darshg321/Icey/assets/3DPCB.png

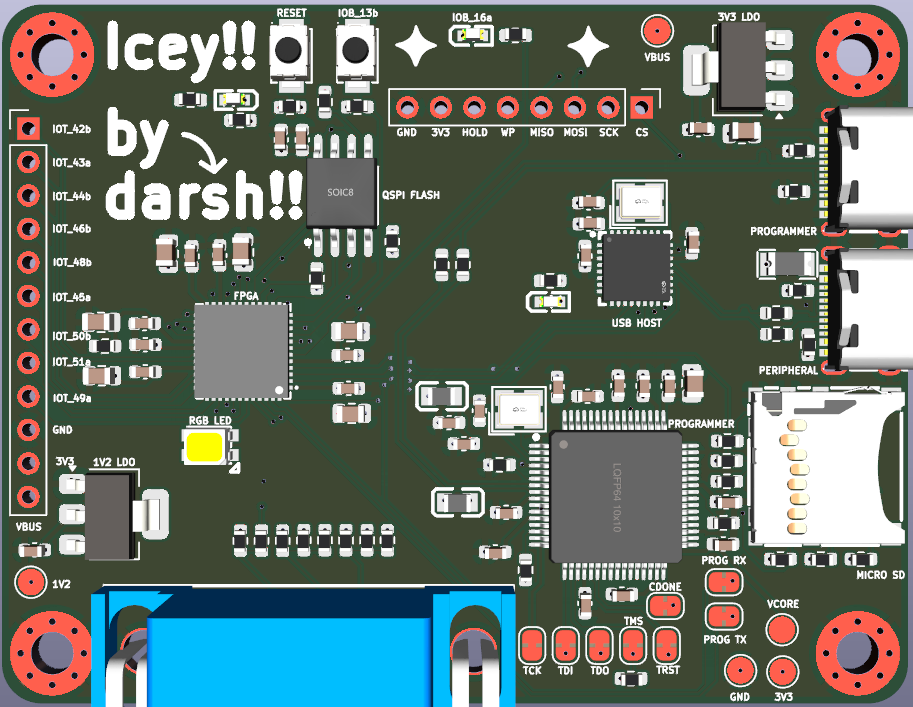
assets/3DPCB.png
