darshg321/Icey/assets/3DPCBBACK.png

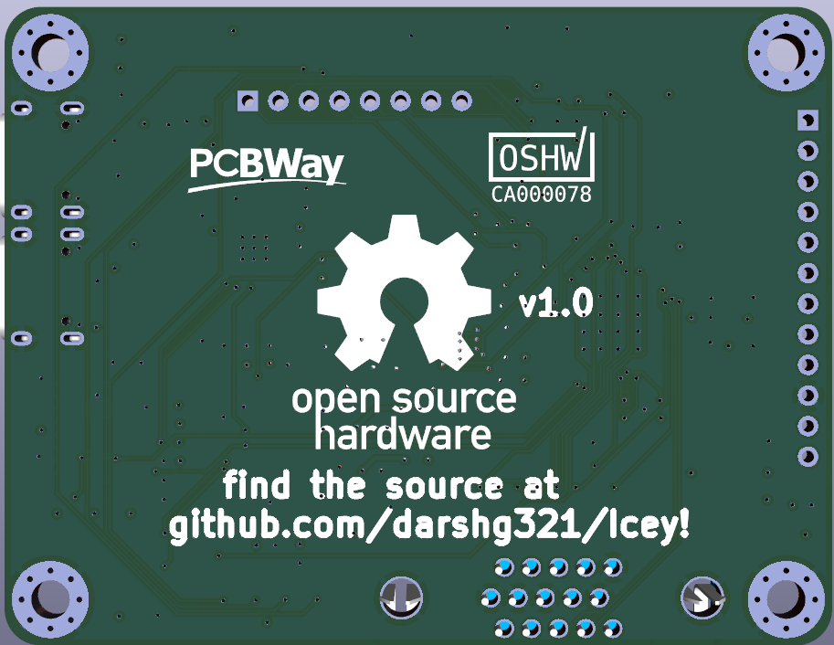
assets/3DPCBBACK.png
