darshg321/Icey/assets/3PCBBACK.png

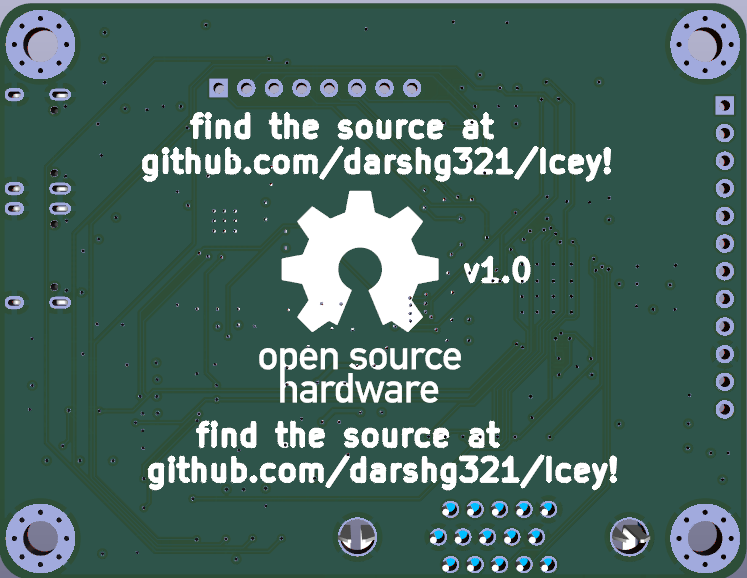
assets/3PCBBACK.png
