darshg321/Icey/assets/layer2.png

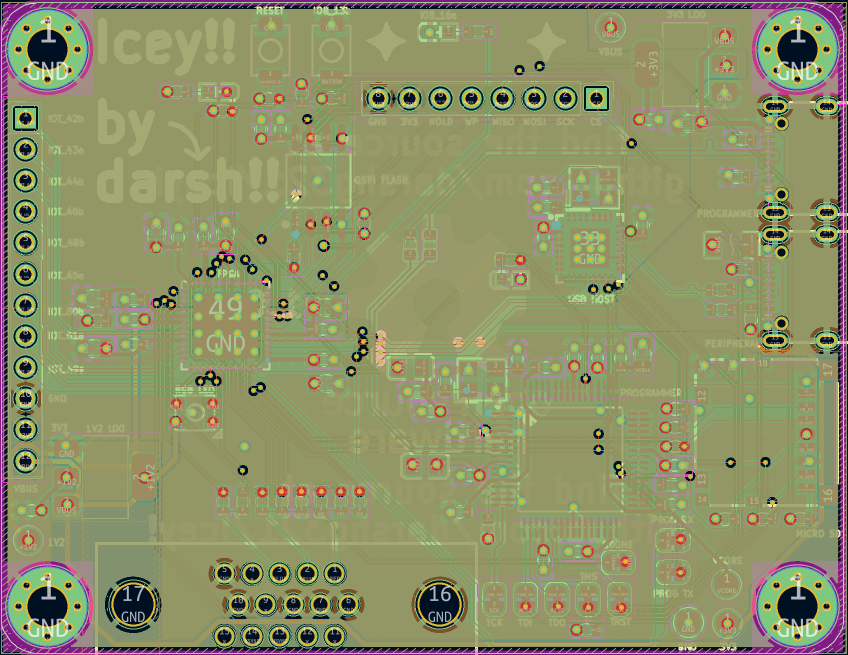
assets/layer2.png
