darshg321/Icey/assets/layer3.png

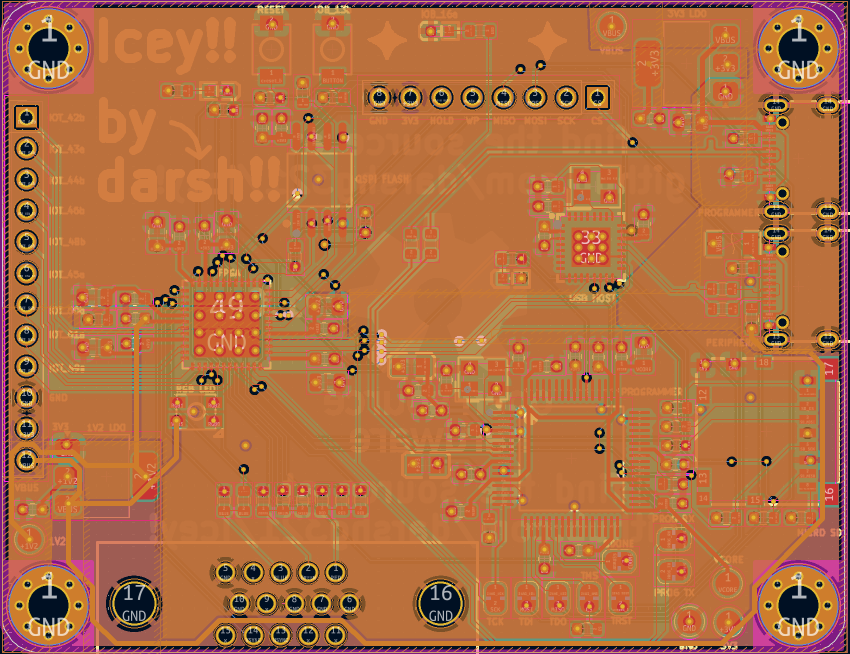
assets/layer3.png
