darshg321/Icey/assets/layer4.png

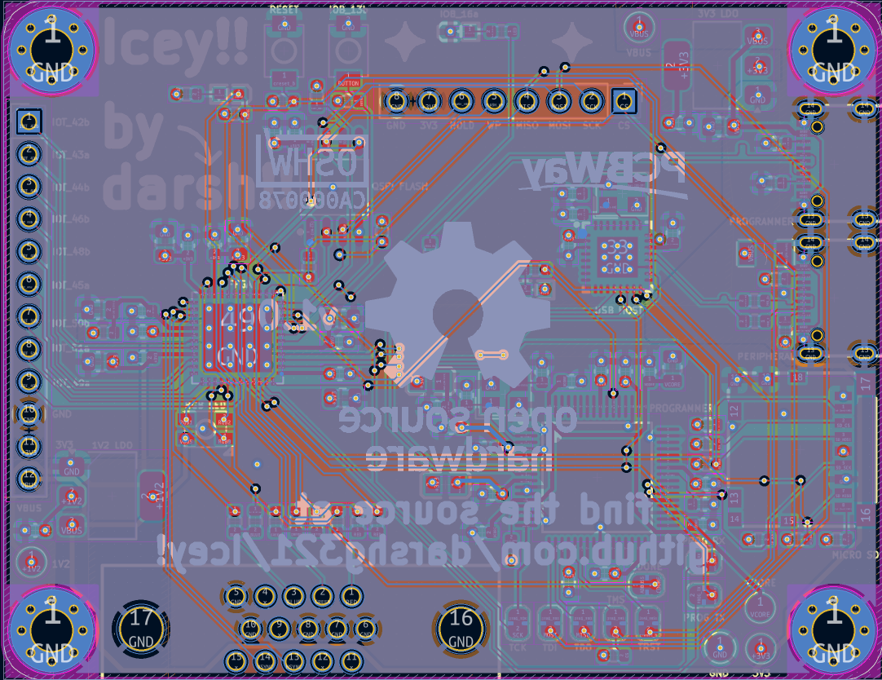
assets/layer4.png
