darshg321/Icey/JLC_BOM.csv

JLCPCB BOM Tool - BOM Matching
BOM name：production_bom-JLCPCB Assembly Order.xlsx |  |  | Download Time：2026-08-05 03:41:00 |  |  |  | * Our matching results are updated in real-time, but stock and prices may change. If it's been over 24 hours, please re-match before placing your order.
PCB Assembled Qty：5 |  |  | Est. Total Price：65.4232
Your BOM |  |  |  |  | Matched Parts |  |  |  |  |  |  | Order Information
Top Designator | Bottom Designator | Comment | Footprint | JLCPCB Part # | Matches | Part # | Manufacturer | Footprint | Description | Category | Warning | JLCPCB Part # | Product link | Lib Type | Qty | Source | Total Price ($)
C1,C14,C31,C33,C35,C37,C5,C9 |  | 4.7uF | 0805 |  | Select by System | CL21A475KAQNNNE | Samsung Electro-Mechanics | 0805 | 25V 4.7uF X5R ±10% 0805 Multilayer Ceramic Capacitors MLCC - SMD/SMT ROHS | Multilayer Ceramic Capacitors MLCC - SMD/SMT |  | C1779 | https://jlcpcb.com/partdetail/2131-CL21A475KAQNNNE/C1779 | Basic | 16 | 16 JLCPCB | 0.7264
C2,C26,C29,C4,C40 |  | 1uF | 0603 |  | Select by System | CL10A105KB8NNNC | Samsung Electro-Mechanics | 0603 | 1uF 50V X5R ±10% 0603 Multilayer Ceramic Capacitors MLCC - SMD/SMT ROHS | Multilayer Ceramic Capacitors MLCC - SMD/SMT |  | C15849 | https://jlcpcb.com/partdetail/16531-CL10A105KB8NNNC/C15849 | Basic | 10 | 10 JLCPCB | 0.756
C12,C13,C17,C18,C19,C20,C21,C22,C23,C24,C27,C3,C30,C32,C34,C36,C38,C39,C41,C8 |  | 100nF | 0603 |  | Select by System | CC0603KRX7R9BB104 | YAGEO | 0603 | 100nF 50V X7R ±10% 0603 Multilayer Ceramic Capacitors MLCC - SMD/SMT ROHS | Multilayer Ceramic Capacitors MLCC - SMD/SMT |  | C14663 | https://jlcpcb.com/partdetail/YAGEO-CC0603KRX7R9BB104/C14663 | Basic | 40 | 40 JLCPCB | 0.904
C15,C16,C6,C7 |  | 22pF | 0603 |  | Select by System | CL10C220JB8NNNC | Samsung Electro-Mechanics | 0603 | 22pF 50V C0G ±5% 0603 Multilayer Ceramic Capacitors MLCC - SMD/SMT ROHS | Multilayer Ceramic Capacitors MLCC - SMD/SMT |  | C1653 | https://jlcpcb.com/partdetail/2005-CL10C220JB8NNNC/C1653 | Basic | 8 | 8 JLCPCB | 0.0536
CARD1 |  | TF-008 | TF-SMD_TF-008 |  | Select by System | TF-008 | SOFNG | SMD | -35℃~+85℃ 1.35mm Connector and Ejector MicroSD Card (TF Card) Push-Pull Yes SMD SD Card / Memory Card Connector ROHS | SD Card / Memory Card Connector |  | C428465 | https://jlcpcb.com/partdetail/SOFNG-TF008/C428465 | Extended | 2 | 2 JLCPCB | 0.6584
DSUB1 |  | VGA-002 | D-SUB-TH_VGA-002 |  | Select by System | VGA-002 | BOOMELE(Boom Precision Elec) | 弯插 | 15P 3 30V 500mA Blue Female High Density D-Sub Right Angle 弯插 D-Sub / VGA Connectors ROHS | D-Sub / VGA Connectors |  | C138387 | https://jlcpcb.com/partdetail/BOOMELE_Boom_Precision_Elec-VGA002/C138387 | Extended | 2 | 2 JLCPCB | 0.5248
F1 |  | MF-NSMF020-2 | F1206 |  | Select by System | MF-NSMF020-2 | BOURNS | 1206 | -40℃~+85℃ 1.6mm 10A 2.6Ω 200mA 24V 3.2mm 600mΩ 1206 Resettable Fuses ROHS | Resettable Fuses |  | C185112 | https://jlcpcb.com/partdetail/BOURNS-MF_NSMF0202/C185112 | Extended | 6 | 6 JLCPCB | 0.2298
L1,L2 |  | 600@100MHz | L0805 |  | Select by System | GZ2012D601TF | Sunlord | 0805 | -55℃~+125℃ 1 300mΩ 500mA 600Ω@100MHz ±25% 0805 Ferrite Beads ROHS | Ferrite Beads |  | C1017 | https://jlcpcb.com/partdetail/Sunlord-GZ2012D601TF/C1017 | Basic | 4 | 4 JLCPCB | 0.1144
LED1,LED2,LED3 |  | KT-0603R | LED-SMD_L1.6-W0.8-R-RD |  | Select by System | KT-0603R | Hubei KENTO Elec | 0603 | -40℃~+85℃ 1.6mm x 0.8mm square LED 1.8V~2.4V 120° 20mA 300mcd 40mW 615nm~630nm 645nm Discrete Diode Red Water Clear 0603 LED Indication - Discrete ROHS | LED Indication - Discrete |  | C2286 | https://jlcpcb.com/partdetail/Hubei_KENTOElec-KT0603R/C2286 | Basic | 6 | 6 JLCPCB | 0.0444
LED4 |  | S4-3528RGBTA-A | LED-SMD_4P-L3.2-W2.8-LS3.5-TL-1 |  | Select by System | S4-3528RGBTA-A | TUOZHAN | SMD3528-4P | -40℃~+85℃ 1.9mm 120° 2.8mm 3.5mm B:461nm~470nm、G:518nm~527nm、R:617nm~626nm Common Anode G:2000V、B:2000V、R:2500V R:1.8V~2.4V、G:2.8V~3.4V、B:2.8V~3.4V R:20mA、G:20mA、B:20mA R:460mcd~1000mcd、G:1300mcd~2900mcd、B:350mcd~780mcd R:60mW、G:90mW、B:90mW Water Clear SMD3528-4P RGB LEDs ROHS | RGB LEDs |  | C2827321 | https://jlcpcb.com/partdetail/TUOZHAN-S4_3528RGBTAA/C2827321 | Extended | 10 | 10 JLCPCB | 0.262
R3,R4 |  | 5.1K | 0603 |  | Unconfirmed | 0603WAF5101T5E | UNI-ROYAL(Uniroyal Elec) | 0603 | -55℃~+155℃ 100mW 5.1kΩ 75V Thick Film Resistor ±1% ±100ppm/℃ 0603 Chip Resistor - Surface Mount ROHS | Chip Resistor - Surface Mount | 1.The comment (0603WAF5101T5E) of this part does not match the one (5.1K) provided in your BOM. Please confirm; | C23186 | https://jlcpcb.com/partdetail/23913-0603WAF5101T5E/C23186 | Basic | 4 | 4 JLCPCB | 0.0336
R5,R6 |  | 33 | 0603 |  | Unconfirmed | 0603WAF330JT5E | UNI-ROYAL(Uniroyal Elec) | 0603 | -55℃~+155℃ 100mW 33Ω 75V Thick Film Resistor ±1% ±100ppm/℃ 0603 Chip Resistor - Surface Mount ROHS | Chip Resistor - Surface Mount | 1.The comment (0603WAF330JT5E) of this part does not match the one (33) provided in your BOM. Please confirm; | C23140 | https://jlcpcb.com/partdetail/23867-0603WAF330JT5E/C23140 | Basic | 4 | 4 JLCPCB | 0.0316
R14,R15,R35 |  | 0 | 0603 |  | Unconfirmed | 0603WAF0000T5E | UNI-ROYAL(Uniroyal Elec) | 0603 | -55℃~+155℃ 0Ω 100mW 75V Thick Film Resistor ±1% 0603 Chip Resistor - Surface Mount ROHS | Chip Resistor - Surface Mount | 1.The comment (0603WAF0000T5E) of this part does not match the one (0) provided in your BOM. Please confirm; | C21189 | https://jlcpcb.com/partdetail/21903-0603WAF0000T5E/C21189 | Basic | 6 | 6 JLCPCB | 0.0492
R16 |  | 12K | 0603 |  | Unconfirmed | 0603WAF1202T5E | UNI-ROYAL(Uniroyal Elec) | 0603 | -55℃~+155℃ 100mW 12kΩ 75V Thick Film Resistor ±1% ±100ppm/℃ 0603 Chip Resistor - Surface Mount ROHS | Chip Resistor - Surface Mount | 1.The comment (0603WAF1202T5E) of this part does not match the one (12K) provided in your BOM. Please confirm; | C22790 | https://jlcpcb.com/partdetail/23517-0603WAF1202T5E/C22790 | Basic | 2 | 2 JLCPCB | 0.0172
R17,R19,R20,R21,R34,R38,R39,R41,R42,R45,R46,R47,R48 |  | 10K | 0603 |  | Unconfirmed | 0603WAF1002T5E | UNI-ROYAL(Uniroyal Elec) | 0603 | -55℃~+155℃ 100mW 10kΩ 75V Thick Film Resistor ±1% ±100ppm/℃ 0603 Chip Resistor - Surface Mount ROHS | Chip Resistor - Surface Mount | 1.The comment (0603WAF1002T5E) of this part does not match the one (10K) provided in your BOM. Please confirm; | C25804 | https://jlcpcb.com/partdetail/26547-0603WAF1002T5E/C25804 | Basic | 26 | 26 JLCPCB | 0.0546
R18 |  | 270 | 0603 |  | Unconfirmed | 0603WAF2700T5E | UNI-ROYAL(Uniroyal Elec) | 0603 | -55℃~+155℃ 100mW 270Ω 75V Thick Film Resistor ±1% ±100ppm/℃ 0603 Chip Resistor - Surface Mount ROHS | Chip Resistor - Surface Mount | 1.The comment (0603WAF2700T5E) of this part does not match the one (270) provided in your BOM. Please confirm; | C22966 | https://jlcpcb.com/partdetail/23693-0603WAF2700T5E/C22966 | Basic | 2 | 2 JLCPCB | 0.0054
R24,R28,R32,R36 |  | 510 | 0603 |  | Unconfirmed | 0603WAF5100T5E | UNI-ROYAL(Uniroyal Elec) | 0603 | -55℃~+155℃ 100mW 510Ω 75V Thick Film Resistor ±1% ±100ppm/℃ 0603 Chip Resistor - Surface Mount ROHS | Chip Resistor - Surface Mount | 1.The comment (0603WAF5100T5E) of this part does not match the one (510) provided in your BOM. Please confirm; | C23193 | https://jlcpcb.com/partdetail/23920-0603WAF5100T5E/C23193 | Basic | 8 | 8 JLCPCB | 0.0816
R25,R29,R9 |  | 1K | 0603 |  | Unconfirmed | 0603WAF1001T5E | UNI-ROYAL(Uniroyal Elec) | 0603 | -55℃~+155℃ 100mW 1kΩ 75V Thick Film Resistor ±1% ±100ppm/℃ 0603 Chip Resistor - Surface Mount ROHS | Chip Resistor - Surface Mount | 1.The comment (0603WAF1001T5E) of this part does not match the one (1K) provided in your BOM. Please confirm; | C21190 | https://jlcpcb.com/partdetail/21904-0603WAF1001T5E/C21190 | Basic | 6 | 6 JLCPCB | 0.036
R26,R27 |  | 2K | 0603 |  | Unconfirmed | 0603WAF2001T5E | UNI-ROYAL(Uniroyal Elec) | 0603 | -55℃~+155℃ 100mW 2kΩ 75V Thick Film Resistor ±1% ±100ppm/℃ 0603 Chip Resistor - Surface Mount ROHS | Chip Resistor - Surface Mount | 1.The comment (0603WAF2001T5E) of this part does not match the one (2K) provided in your BOM. Please confirm; | C22975 | https://jlcpcb.com/partdetail/23702-0603WAF2001T5E/C22975 | Basic | 4 | 4 JLCPCB | 0.036
R30 |  | 820 | 0603 |  | Unconfirmed | 0603WAF8200T5E | UNI-ROYAL(Uniroyal Elec) | 0603 | -55℃~+155℃ 100mW 75V 820Ω Thick Film Resistor ±1% ±100ppm/℃ 0603 Chip Resistor - Surface Mount ROHS | Chip Resistor - Surface Mount | 1.The comment (0603WAF8200T5E) of this part does not match the one (820) provided in your BOM. Please confirm; | C23253 | https://jlcpcb.com/partdetail/23980-0603WAF8200T5E/C23253 | Basic | 2 | 2 JLCPCB | 0.005
R31 |  | 430 | 0603 |  | Select by Customer | 0603WAF4302T5E | UNI-ROYAL(Uniroyal Elec) | 0603 | -55℃~+155℃ 100mW 43kΩ 75V Thick Film Resistor ±1% ±100ppm/℃ 0603 Chip Resistor - Surface Mount ROHS | Chip Resistor - Surface Mount | 1.The comment (0603WAF4302T5E) of this part does not match the one (430) provided in your BOM. Please confirm; | C23172 | https://jlcpcb.com/partdetail/23899-0603WAF4302T5E/C23172 | Extended | 20 | 20 JLCPCB | 0.152
R33 |  | 100 | 0603 |  | Unconfirmed | 0603WAF1000T5E | UNI-ROYAL(Uniroyal Elec) | 0603 | -55℃~+155℃ 100mW 100Ω 75V Thick Film Resistor ±1% ±100ppm/℃ 0603 Chip Resistor - Surface Mount ROHS | Chip Resistor - Surface Mount | 1.The comment (0603WAF1000T5E) of this part does not match the one (100) provided in your BOM. Please confirm; | C22775 | https://jlcpcb.com/partdetail/23502-0603WAF1000T5E/C22775 | Basic | 2 | 2 JLCPCB | 0.0064
R40,R44 |  | 56K | 0603 |  | Unconfirmed | 0603WAF5602T5E | UNI-ROYAL(Uniroyal Elec) | 0603 | -55℃~+155℃ 100mW 56kΩ 75V Thick Film Resistor ±1% ±100ppm/℃ 0603 Chip Resistor - Surface Mount ROHS | Chip Resistor - Surface Mount | 1.The comment (0603WAF5602T5E) of this part does not match the one (56K) provided in your BOM. Please confirm; | C23206 | https://jlcpcb.com/partdetail/23933-0603WAF5602T5E/C23206 | Basic | 4 | 4 JLCPCB | 0.0324
SW2,SW3 |  | TS-1088-AR02016 | SW-SMD_L3.9-W3.0-P4.45 |  | Select by System | TS-1088-AR02016 | XUNPU | SMD,4x3mm | -30℃~+80℃ 1.6N 100,000 cycles 12V 2mm 3.9mm 3mm 50mA Black Round Button SMD(SMT) Tab SPST Surface Mount,Vertical Without Bracket SMD,4x3mm Tactile Switches ROHS | Tactile Switches |  | C720477 | https://jlcpcb.com/partdetail/XUNPU-TS_1088AR02016/C720477 | Basic | 4 | 4 JLCPCB | 0.2208
U1 |  | AMS1117-1.2 | SOT-223-3_TabPin2 |  | Select by System | AMS1117-1.2 | UMW(Youtai Semiconductor Co., Ltd.) | SOT-223 | -40℃~+125℃@(Tj) 0.003%Vout 1 1.2V 1.3V@(1A) 10mA 18V 1A 60dB@(120Hz) Fixed Over Current Protection Positive SOT-223 Voltage Regulators - Linear, Low Drop Out (LDO) Regulators ROHS | Voltage Regulators - Linear, Low Drop Out (LDO) Regulators |  | C347218 | https://jlcpcb.com/partdetail/323878-AMS1117_12/C347218 | Extended | 2 | 2 JLCPCB | 0.1002
U2 |  | ICE40UP5K-SG48I | QFN-48_L7.0-W7.0-P0.50-TL-EP5.4-1 |  | Select by System | ICE40UP5K-SG48I | Lattice | QFN-48-EP(7x7) | -40℃~+100℃ 1171456bit 5280 660 QFN-48-EP(7x7) Programmable Logic Device (CPLDs/FPGAs) ROHS | Programmable Logic Device (CPLDs/FPGAs) |  | C2678152 | https://jlcpcb.com/partdetail/Lattice-ICE40UP5KSG48I/C2678152 | Extended | 2 | 2 JLCPCB | 16.9878
U3 |  | MAX3421EETJ+T | VQFN-32_L5.0-W5.0-P0.50-BL-EP3.2 |  | Select by System | MAX3421EETJ+T | Analog Devices Inc./Maxim Integrated | VQFN-32-EP(5x5) | -40℃~+85℃ 12Mbps 3.3V 45mA 60uA USB 2.0 USB to SPI VQFN-32-EP(5x5) USB Converters ROHS | USB Converters |  | C1870151 | https://jlcpcb.com/partdetail/1960966-MAX3421EETJT/C1870151 | Extended | 2 | 2 JLCPCB | 13.183
U4 |  | W25Q128JVSIQTR | SOIC-8_L5.3-W5.3-P1.27-LS8.0-BL |  | Select by System | W25Q128JVSIQ | Winbond Elec | SOIC-8-208mil | -40℃~+85℃ 100,000 cycles 120ms@(32KB) 128Mbit 133MHz 1uA 2.7V~3.6V 20 Years 3ms Power-on reset、Hardware write protection、Software write protection、Write enable latch、Absolute write protection SPI SOIC-8-208mil NOR FLASH ROHS | NOR FLASH |  | C97521 | https://jlcpcb.com/partdetail/WinbondElec-W25Q128JVSIQ/C97521 | Basic | 2 | 2 JLCPCB | 5.5218
U5 |  | AMS1117-3.3 | SOT-223-3_TabPin2 |  | Select by System | AMS1117-3.3 | Advanced Monolithic Systems | SOT-223 | -40℃~+125℃ 0.003%Vout 1 1.1V@(800mA) 15V 1A 3.3V 5mA 72dB@(120Hz) Fixed Over Current Protection、Short Circuit Protection、Thermal shutdown Positive SOT-223 Voltage Regulators - Linear, Low Drop Out (LDO) Regulators ROHS | Voltage Regulators - Linear, Low Drop Out (LDO) Regulators |  | C6186 | https://jlcpcb.com/partdetail/Advanced_MonolithicSystems-AMS1117_33/C6186 | Basic | 2 | 2 JLCPCB | 0.4012
U6 |  | FT2232HL | LQFP-64_L10.0-W10.0-P0.50-LS12.0-TL |  | Select by System | FT2232HL-REEL | FTDI | LQFP-64(10x10) | -40℃~+85℃ 2 480Mbps USB 2.0 USB to UART、USB to FIFO LQFP-64(10x10) USB Converters ROHS | USB Converters |  | C27882 | https://jlcpcb.com/partdetail/FTDI-FT2232HLREEL/C27882 | Extended | 2 | 2 JLCPCB | 23.4452
USB1,USB2 |  | TYPE-C16PIN2MD | USB-C-SMD_TYPE-C-16PIN-2MD-073 |  | Select by System | TYPE-C 16PIN 2MD(073) | SHOU HAN | SMD | -25℃~+85℃ 1 16P 3A 5,000 times 5V Black Female Surface Mount, Right Angle Type-C SMD USB Connectors ROHS | USB Connectors |  | C2765186 | https://jlcpcb.com/partdetail/SHOUHAN-TYPE_C_16PIN_2MD_073/C2765186 | Extended | 5 | 5 JLCPCB | 0.368
X1,X2 |  | X322512MSB4SI | CRYSTAL-SMD_4P-L3.2-W2.5-BL |  | Select by System | X322512MSB4SI | YXC Crystal Oscillators | SMD3225-4P | -40℃~+85℃ 12MHz 20pF Crystal Oscillator ±10ppm ±20ppm SMD3225-4P Crystals ROHS | Crystals |  | C9002 | https://jlcpcb.com/partdetail/YXC_CrystalOscillators-X322512MSB4SI/C9002 | Basic | 4 | 4 JLCPCB | 0.3804
