darshg321/Icey/production/production_bom.csv

Designator | Footprint | Quantity | Value | LCSC Part #
C1, C14, C31, C33, C35, C37, C5, C9 | 0805 | 8 | 4.7uF
C12, C13, C17, C18, C19, C20, C21, C22, C23, C24, C27, C3, C30, C32, C34, C36, C38, C39, C41, C8 | 0603 | 20 | 100nF
C15, C16, C6, C7 | 0603 | 4 | 22pF
C2, C26, C29, C4, C40 | 0603 | 5 | 1uF
CARD1 | TF-SMD_TF-008 | 1 | TF-008 | C428465
DSUB1 | D-SUB-TH_VGA-002 | 1 | VGA-002 | C138387
F1 | F1206 | 1 | MF-NSMF020-2 | C185112
J1 | PinHeader_1x12_P2.54mm_Vertical | 1 | Conn_01x12
J2 | PinHeader_1x08_P2.54mm_Vertical | 1 | Conn_01x08
L1, L2 | L0805 | 2 | 600@100MHz | C1017
LED1, LED2, LED3 | LED-SMD_L1.6-W0.8-R-RD | 3 | KT-0603R | C2286
LED4 | LED-SMD_4P-L3.2-W2.8-LS3.5-TL-1 | 1 | S4-3528RGBTA-A | C2827321
R14, R15, R35 | 0603 | 3 | 0
R16 | 0603 | 1 | 12K
R17, R19, R20, R21, R34, R38, R39, R41, R42, R45, R46, R47, R48 | 0603 | 13 | 10K
R18 | 0603 | 1 | 270
R24, R28, R32, R36 | 0603 | 4 | 510
R25, R29, R9 | 0603 | 3 | 1K
R26, R27 | 0603 | 2 | 2K
R3, R4 | 0603 | 2 | 5.1K
R30 | 0603 | 1 | 820
R31 | 0603 | 1 | 430
R33 | 0603 | 1 | 100
R40, R44 | 0603 | 2 | 56K
R5, R6 | 0603 | 2 | 33
SW2, SW3 | SW-SMD_L3.9-W3.0-P4.45 | 2 | TS-1088-AR02016 | C720477
TP3, TP4, TP5, TP6, TP7 | TestPoint_Pad_D2.0mm | 5 | TestPoint
U1 | SOT-223-3_TabPin2 | 1 | AMS1117-1.2 | C347218
U2 | QFN-48_L7.0-W7.0-P0.50-TL-EP5.4-1 | 1 | ICE40UP5K-SG48I | C2678152
U3 | VQFN-32_L5.0-W5.0-P0.50-BL-EP3.2 | 1 | MAX3421EETJ+T | C1870151
U4 | SOIC-8_L5.3-W5.3-P1.27-LS8.0-BL | 1 | W25Q128JVSIQTR | C97521
U5 | SOT-223-3_TabPin2 | 1 | AMS1117-3.3
U6 | LQFP-64_L10.0-W10.0-P0.50-LS12.0-TL | 1 | FT2232HL | C27882
USB1, USB2 | USB-C-SMD_TYPE-C-16PIN-2MD-073 | 2 | TYPE-C 16PIN 2MD | C2765186
X1, X2 | CRYSTAL-SMD_4P-L3.2-W2.5-BL | 2 | X322512MSB4SI | C9002
