darshg321/Icey/JOURNAL.md

https://lapse.hackclub.com/timelapse/dUVuQwtGuoNT

https://lapse.hackclub.com/timelapse/kNoydn3p9_2V

https://lapse.hackclub.com/timelapse/Cn0KKLVaR2lX

https://lapse.hackclub.com/timelapse/0yt4nqLieavU

https://lapse.hackclub.com/timelapse/_wR7-a1GJmWD

https://lapse.hackclub.com/timelapse/y3aPzREroL90

https://lapse.hackclub.com/timelapse/l5Toxhs7gonE

https://lapse.hackclub.com/timelapse/NctV_41U334b

https://lapse.hackclub.com/timelapse/pN3W1glCVihE

https://lapse.hackclub.com/timelapse/RcOzTzJwzCnX

https://lapse.hackclub.com/timelapse/EgeR_TH6Yb6Q

https://lapse.hackclub.com/timelapse/sCd1icvFmEO3

https://lapse.hackclub.com/timelapse/YxfY_EIsNyJi

https://lapse.hackclub.com/timelapse/UKDQ6DKfIyNX

https://lapse.hackclub.com/timelapse/0LZ5_5kxrGnq

https://lapse.hackclub.com/timelapse/M3O1-R4e4S4K

https://lapse.hackclub.com/timelapse/71hZzpOUVf9u

https://lapse.hackclub.com/timelapse/fiwIgdSgkEqM
