darshg321/Icey/assets/SCHEMATIC.pdf

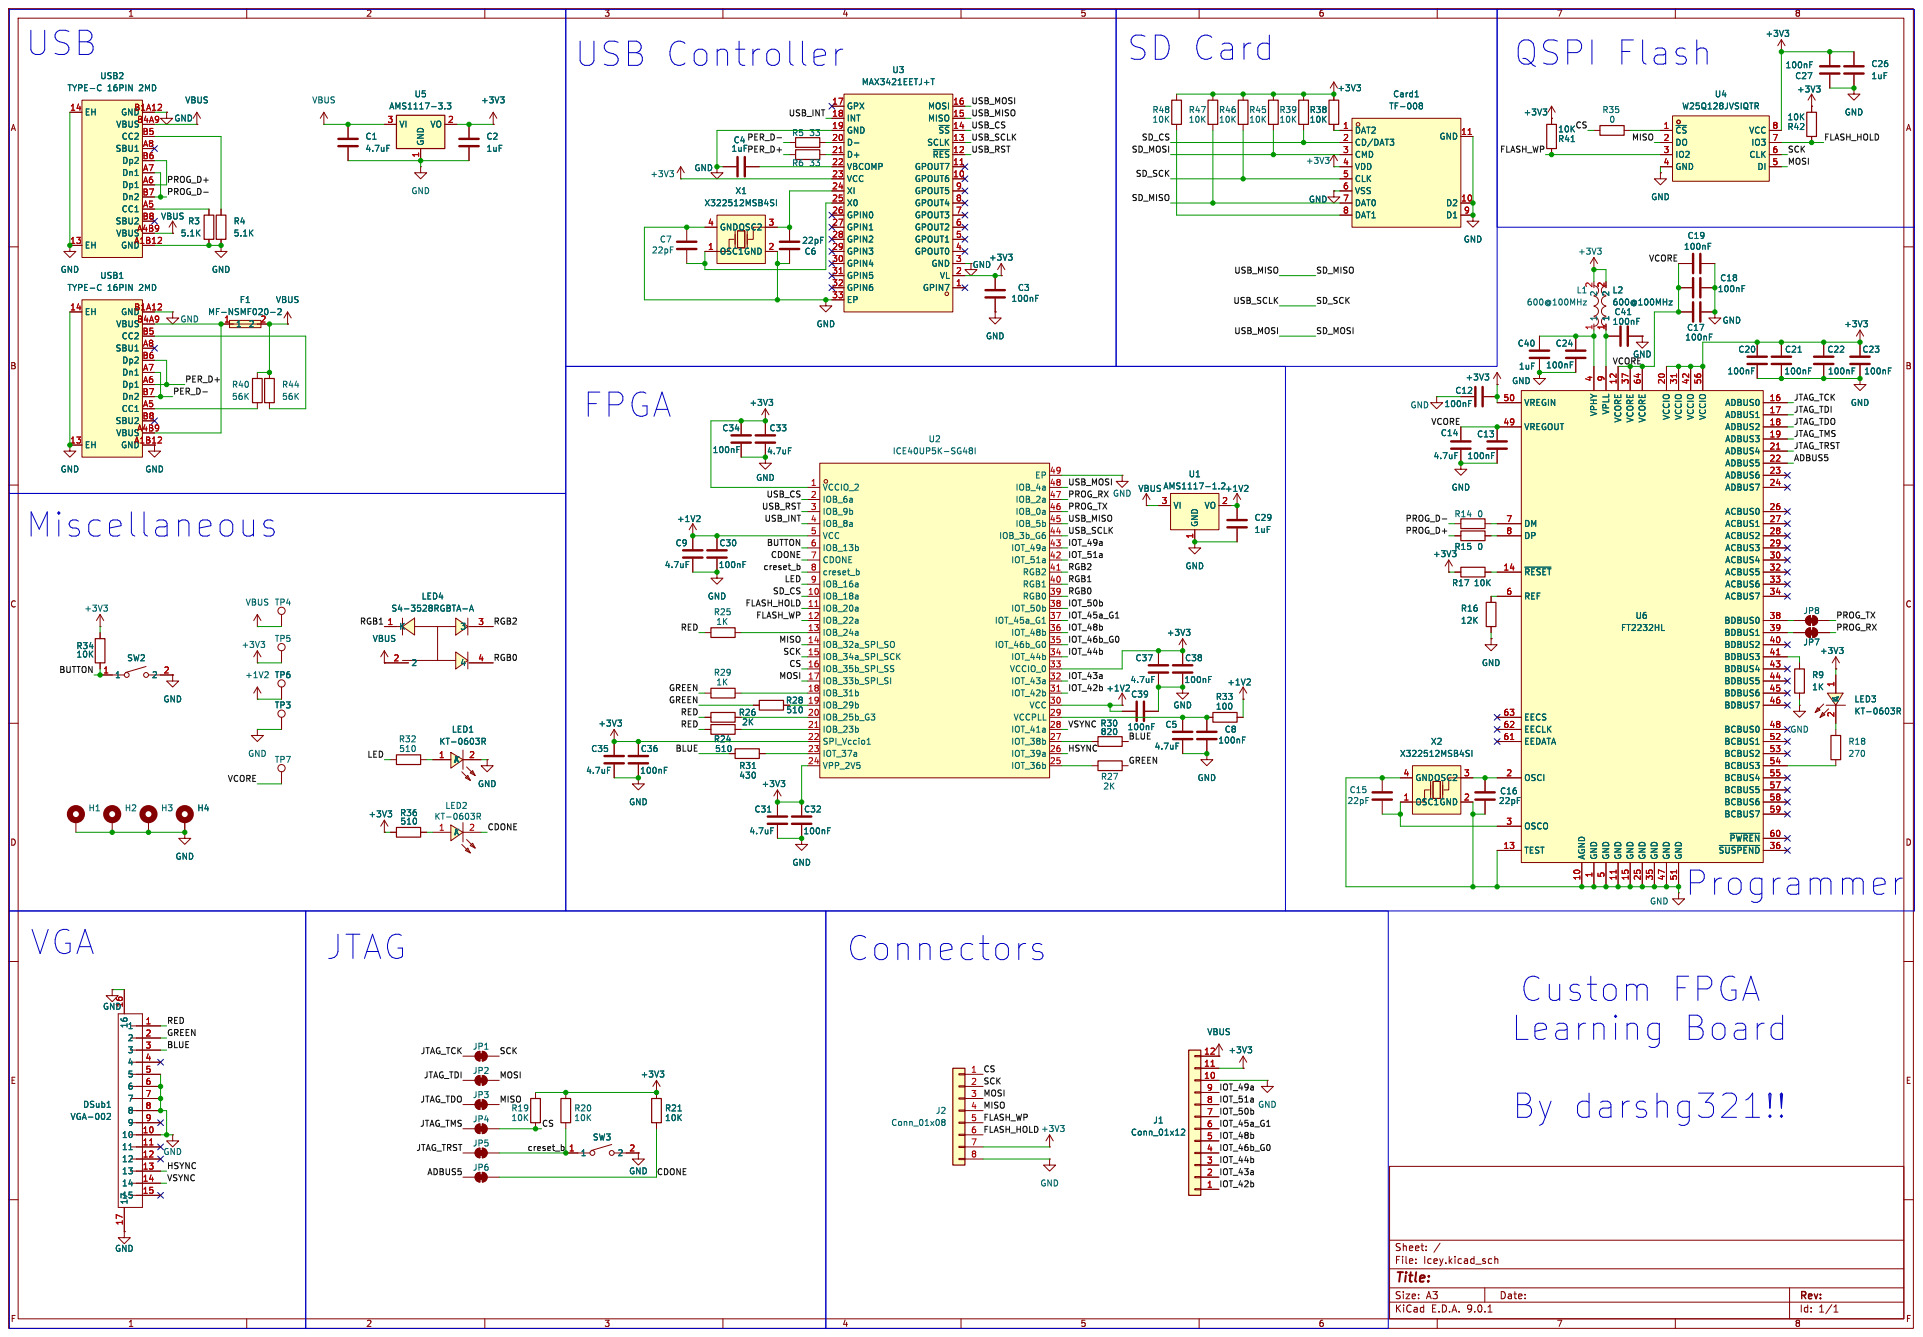
[picture p17: page 1]

USB
USB2 TYPE-C 16PIN 2MD GNDA1B12 VBUSA4B9 SBU2 B8 CC1 A5 Dn2 B7 Dp1 A6 Dn1 A7 Dp2 B6 SBU1 A8 CC2 B5 VBUSB4A9 GNDB1A12 EH 13 EH 14 GND

U3 MAX3421EETJ+TGPIN7 1 VL 2 GND 3 GPOUT0 4 GPOUT1 5 GPOUT2 6 GPOUT3 7 GPOUT4 8 GPOUT5 9 GPOUT6 10 GPOUT7 11 ~{RES} 12 SCLK 13 ~{SS} 14 MISO 15 MOSI 16 EP 33 GPIN6 32 GPIN5 31 GPIN4 30 GPIN3 29 GPIN2 28 GPIN1 27 GPIN0 26 X0 25 XI 24 VCC 23 VBCOMP 22 D+ 21 D- 20 GND 19

5 VCORE 12 GND 11 VCORE 37 GND 15 VCORE 64 GND 25 GND 35 VCCIO 20 GND 47 VCCIO 31 GND 51 VCCIO 42 VCCIO 56 ADBUS0

1 +3V3 U6 FT2232HL VREGIN 50 VREGOUT 49 DM 7 DP 8 ~{RESET} 14 REF 6 EECS 63 EECLK 62 EEDATA 61 OSCI 2 OSCO 3 TEST 13 AGND 10 VPHY
