darshg321/Icey/PCB/Icey.kicad_pcb

## KiCad design PCB/Icey.kicad_pcb (2026-08-17)

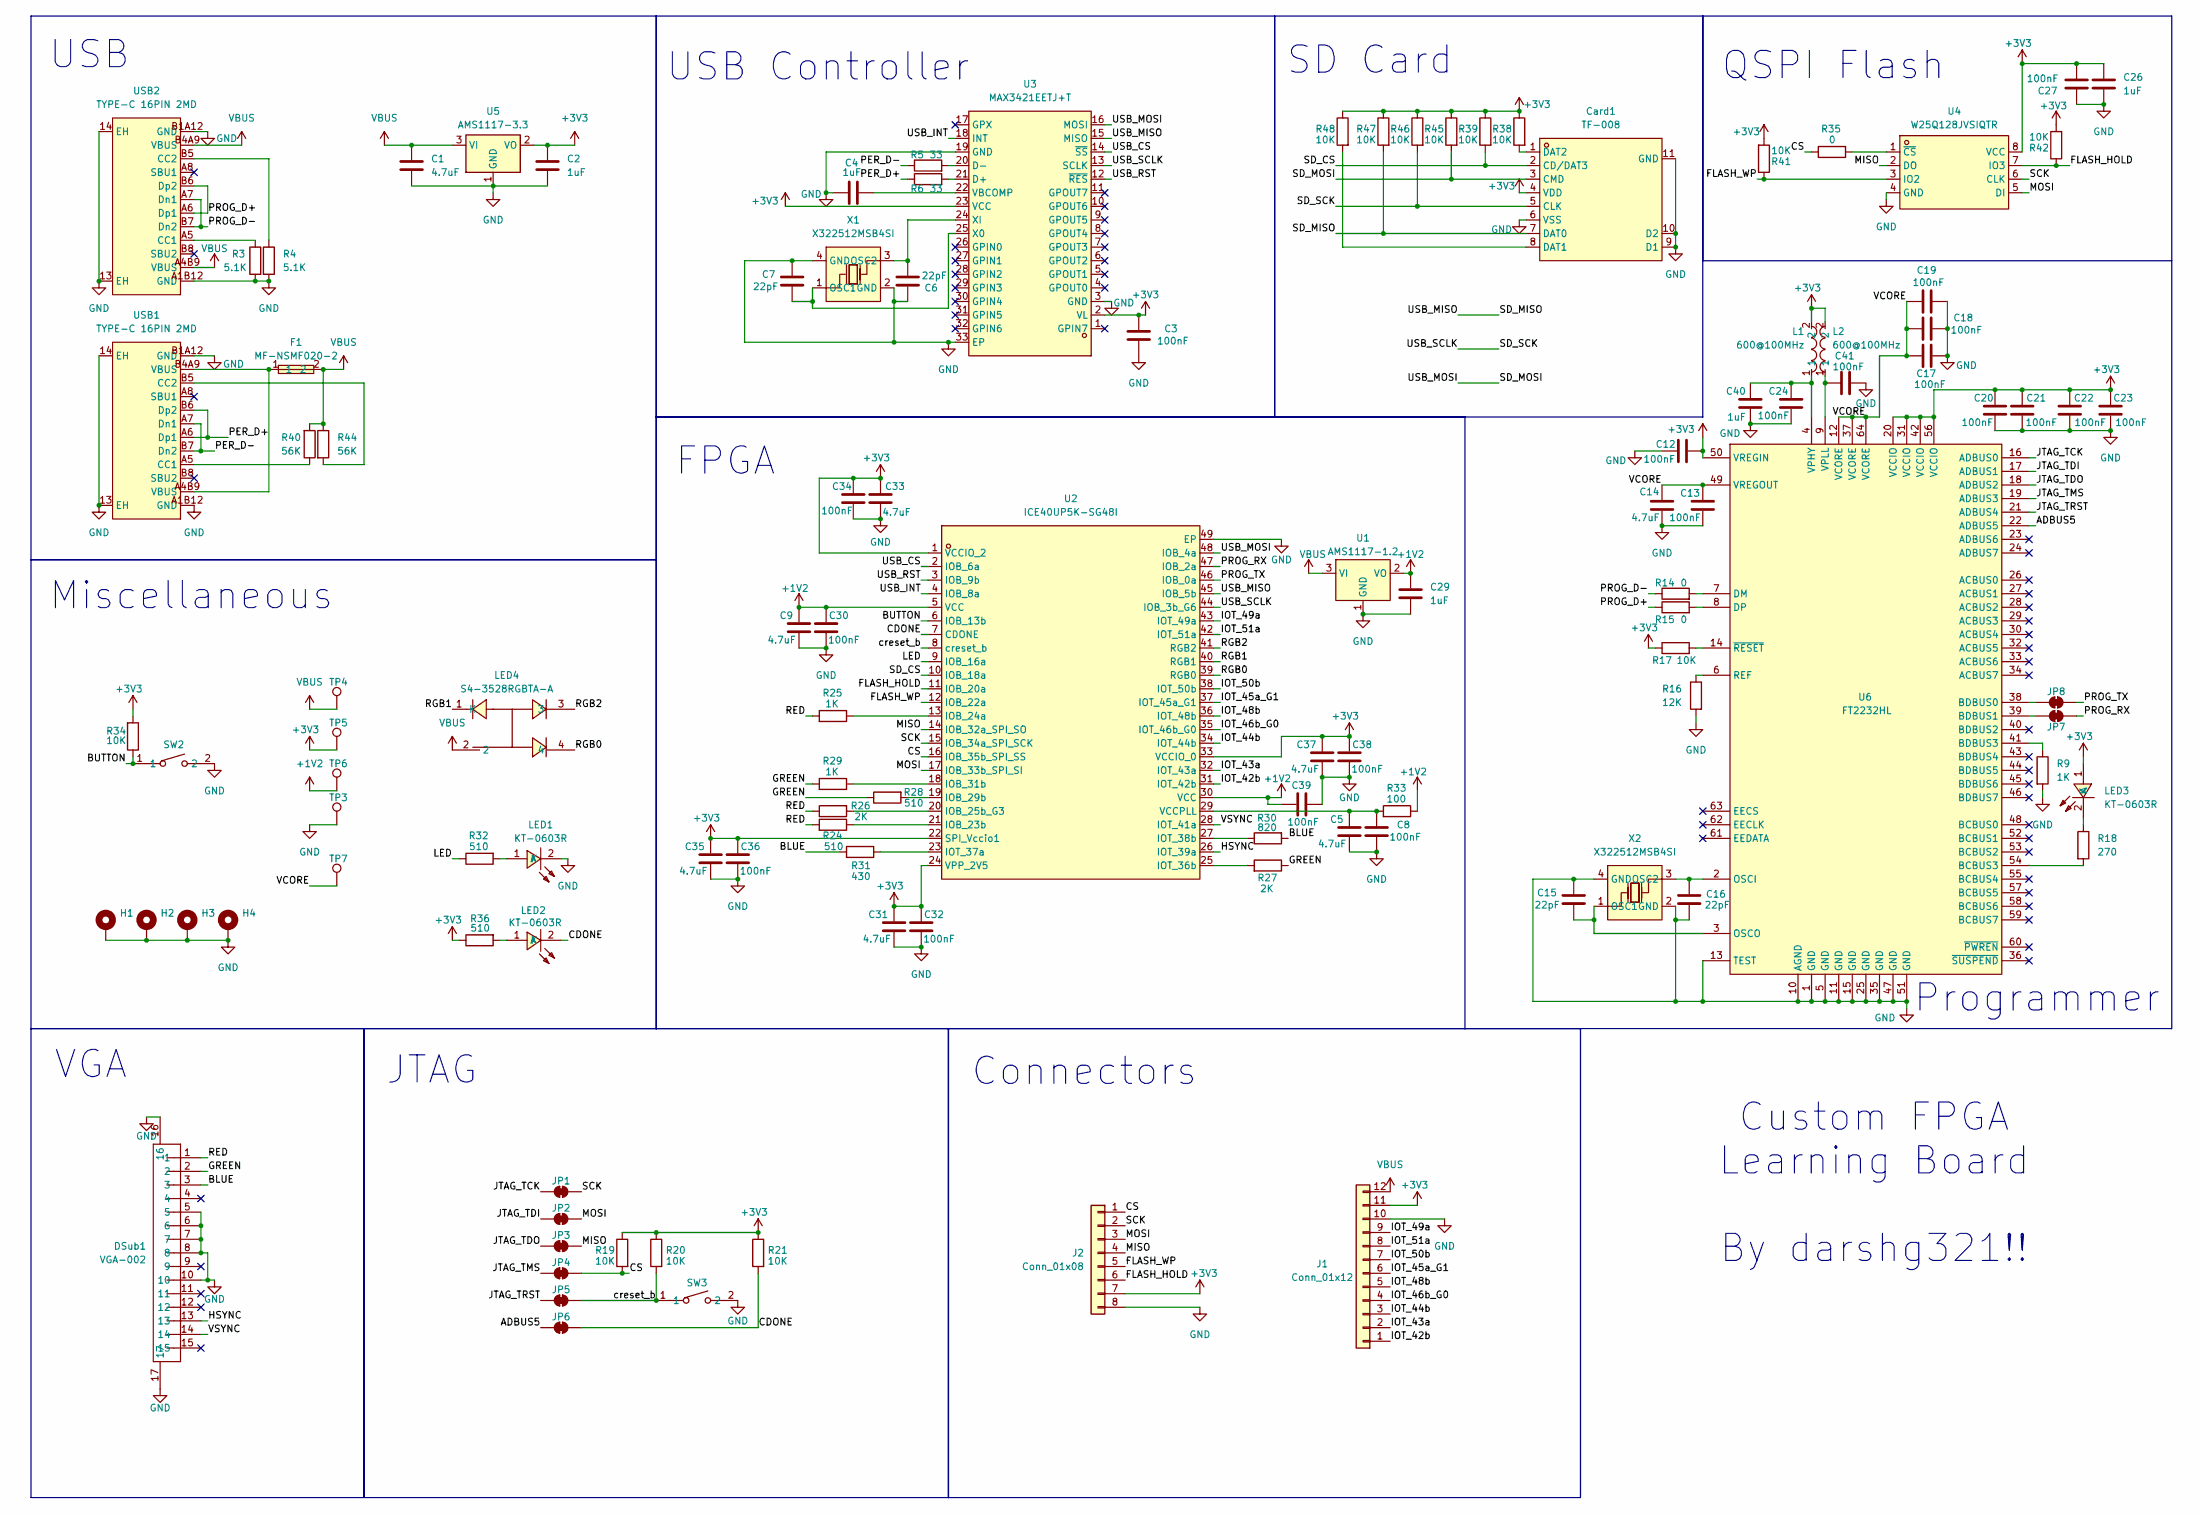
[picture p18: schematic Icey.kicad_sch]

Parts:
C1, C5, C9, C14, C31, C33, C35, C37: 4.7uF; C_0805_2012Metric
C2, C4, C26, C29, C40: 1uF; C_0603_1608Metric
C3, C8, C12, C13, C17, C18, C19, C20, C21, C22, C23, C24, C27, C30, C32, C34, C36, C38, C39, C41: 100nF; C_0603_1608Metric
C6, C7, C15, C16: 22pF; C_0603_1608Metric
Card1: TF-008; TF-SMD_TF-008; MPN TF-008; LCSC Part C428465
DSub1: VGA-002; D-SUB-TH_VGA-002; MPN VGA-002; LCSC Part C138387
F1: MF-NSMF020-2; F1206; MPN MF-NSMF020-2; LCSC Part C185112
H1, H2, H3, H4: MountingHole_Pad; MountingHole_3.2mm_M3_Pad_Via
J1: Conn_01x12; PinHeader_1x12_P2.54mm_Vertical
J2: Conn_01x08; PinHeader_1x08_P2.54mm_Vertical
JP1, JP2, JP3, JP4, JP5, JP6, JP7, JP8: SolderJumper_2_Bridged; SolderJumper-2_P1.3mm_Bridged_RoundedPad1.0x1.5mm
L1, L2: 600@100MHz; L0805; MPN GZ2012D601TF; LCSC Part C1017
LED1, LED2, LED3: KT-0603R; LED-SMD_L1.6-W0.8-R-RD; MPN KT-0603R; LCSC Part C2286
LED4: S4-3528RGBTA-A; LED-SMD_4P-L3.2-W2.8-LS3.5-TL-1; MPN S4-3528RGBTA-A; LCSC Part C2827321
R3, R4: 5.1K; R_0603_1608Metric
R5, R6: 33; R_0603_1608Metric
R9, R25, R29: 1K; R_0603_1608Metric
R14, R15, R35: 0; R_0603_1608Metric
R16: 12K; R_0603_1608Metric
R17, R19, R20, R21, R34, R38, R39, R41, R42, R45, R46, R47, R48: 10K; R_0603_1608Metric
R18: 270; R_0603_1608Metric
R24, R28, R32, R36: 510; R_0603_1608Metric
R26, R27: 2K; R_0603_1608Metric
R30: 820; R_0603_1608Metric
R31: 430; R_0603_1608Metric
R33: 100; R_0603_1608Metric
R40, R44: 56K; R_0603_1608Metric
SW2, SW3: TS-1088-AR02016; SW-SMD_L3.9-W3.0-P4.45; MPN TS-1088-AR02016; LCSC Part C720477
TP3, TP4, TP5, TP6, TP7: TestPoint; TestPoint_Pad_D2.0mm
U1: AMS1117-1.2; SOT-223-3_TabPin2; MPN AMS1117-1.2; LCSC Part C347218
U2: ICE40UP5K-SG48I; QFN-48_L7.0-W7.0-P0.50-TL-EP5.4-1; MPN ICE40UP5K-SG48I; LCSC Part C2678152
U3: MAX3421EETJ+T; VQFN-32_L5.0-W5.0-P0.50-BL-EP3.2; MPN MAX3421EETJ+T; LCSC Part C1870151
U4: W25Q128JVSIQTR; SOIC-8_L5.3-W5.3-P1.27-LS8.0-BL; MPN W25Q128JVSIQ; LCSC Part C97521
U5: AMS1117-3.3; SOT-223-3_TabPin2
U6: FT2232HL; LQFP-64_L10.0-W10.0-P0.50-LS12.0-TL; MPN FT2232HL-REEL; LCSC Part C27882
USB1, USB2: TYPE-C 16PIN 2MD; USB-C-SMD_TYPE-C-16PIN-2MD-073; MPN TYPE-C 16PIN 2MD(073); LCSC Part C2765186
X1, X2: X322512MSB4SI; CRYSTAL-SMD_4P-L3.2-W2.5-BL; MPN X322512MSB4SI; LCSC Part C9002

Connections:
+1V2: C9.2, C29.1, C30.2, C39.2, R33.1, TP6.1, U1.2 (VO), U2.5 (VCC), U2.30 (VCC)
+3V3: C2.1, C3.2, C12.1, C20.1, C21.2, C22.2, C23.2, C26.1, C27.1, C31.2, C32.2, C33.1, C34.1, C35.2, C36.2, C37.2, C38.2, Card1.4 (VDD), J1.11, J2.7, L1.2, L2.2, LED3.1 (A), R17.1, R19.1, R20.1, R21.1, R34.2, R36.1, R38.1, R39.1, R41.2, R42.2, R45.1, R46.1, R47.1, R48.1, TP5.1, U2.1 (VCCIO_2), U2.22 (SPI_Vccio1), U2.24 (VPP_2V5), U2.33 (VCCIO_0), U3.2 (VL), U3.23 (VCC), U4.8 (VCC), U5.2 (VO), U6.20 (VCCIO), U6.31 (VCCIO), U6.42 (VCCIO), U6.50 (VREGIN), U6.56 (VCCIO)
/ADBUS5: JP6.1 (A), U6.22 (ADBUS5)
/BLUE: DSub1.3, R30.2, R31.2
/BUTTON: R34.1, SW2.1, U2.6 (IOB_13b)
/CDONE: JP6.2 (B), LED2.2 (K), R21.2, U2.7 (CDONE)
/CS: J2.1, JP4.2 (B), R19.2, R35.1, U2.16 (IOB_35b_SPI_SS)
/FLASH_HOLD: J2.6, R42.1, U2.11 (IOB_20a), U4.7 (IO3)
/FLASH_WP: J2.5, R41.1, U2.12 (IOB_22a), U4.3 (IO2)
/GREEN: DSub1.2, R27.1, R28.1, R29.2
/HSYNC: DSub1.13, U2.26 (IOT_39a)
/IOT_42b: J1.1, U2.31 (IOT_42b)
/IOT_43a: J1.2, U2.32 (IOT_43a)
/IOT_44b: J1.3, U2.34 (IOT_44b)
/IOT_45a_G1: J1.6, U2.37 (IOT_45a_G1)
/IOT_46b_G0: J1.4, U2.35 (IOT_46b_G0)
/IOT_48b: J1.5, U2.36 (IOT_48b)
/IOT_49a: J1.9, U2.43 (IOT_49a)
/IOT_50b: J1.7, U2.38 (IOT_50b)
/IOT_51a: J1.8, U2.42 (IOT_51a)
/JTAG_TCK: JP1.1 (A), U6.16 (ADBUS0)
/JTAG_TDI: JP2.1 (A), U6.17 (ADBUS1)
/JTAG_TDO: JP3.1 (A), U6.18 (ADBUS2)
/JTAG_TMS: JP4.1 (A), U6.19 (ADBUS3)
/JTAG_TRST: JP5.1 (A), U6.21 (ADBUS4)
/LED: R32.1, U2.9 (IOB_16a)
/MISO: J2.4, JP3.2 (B), U2.14 (IOB_32a_SPI_SO), U4.2 (DO)
/MOSI: J2.3, JP2.2 (B), U2.17 (IOB_33b_SPI_SI), U4.5 (DI)
/PER_D+: R6.1, USB1.A6 (Dp1), USB1.B6 (Dp2)
/PER_D-: R5.1, USB1.A7 (Dn1), USB1.B7 (Dn2)
/PROG_D+: R15.1, USB2.A6 (Dp1), USB2.B6 (Dp2)
/PROG_D-: R14.1, USB2.A7 (Dn1), USB2.B7 (Dn2)
/PROG_RX: JP7.1 (A), U2.47 (IOB_2a)
/PROG_TX: JP8.2 (B), U2.46 (IOB_0a)
/RED: DSub1.1, R24.2, R25.2, R26.1
/RGB0: LED4.4, U2.39 (RGB0)
/RGB1: LED4.1 (K), U2.40 (RGB1)
/RGB2: LED4.3, U2.41 (RGB2)
/SCK: J2.2, JP1.2 (B), U2.15 (IOB_34a_SPI_SCK), U4.6 (CLK)
/SD_CS: Card1.2 (CD/DAT3), R39.2, U2.10 (IOB_18a)
/SD_MISO: Card1.7 (DAT0), R47.2, U2.45 (IOB_5b), U3.15 (MISO)
/SD_MOSI: Card1.3 (CMD), R45.2, U2.48 (IOB_4a), U3.16 (MOSI)
/SD_SCK: Card1.5 (CLK), R46.2, U2.44 (IOB_3b_G6), U3.13 (SCLK)
/USB_CS: U2.2 (IOB_6a), U3.14 (~SS)
/USB_INT: U2.4 (IOB_8a), U3.18 (INT)
/USB_RST: U2.3 (IOB_9b), U3.12 (~RES)
/VCORE: C13.1, C14.1, C17.1, C18.2, C19.2, TP7.1, U6.12 (VCORE), U6.37 (VCORE), U6.49 (VREGOUT), U6.64 (VCORE)
/VSYNC: DSub1.14, U2.28 (IOT_41a)
/creset_b: JP5.2 (B), R20.2, SW3.1, U2.8 (creset_b)
GND: C1.2, C2.2, C3.1, C4.1, C5.1, C6.2, C7.2, C8.1, C9.1, C12.2, C13.2, C14.2, C15.2, C16.2, C17.2, C18.1, C19.1, C20.2, C21.1, C22.1, C23.1, C24.2, C26.2, C27.2, C29.2, C30.1, C31.1, C32.1, C33.2, C34.2, C35.1, C36.1, C37.1, C38.1, C39.1, C40.1, C41.2, Card1.6 (VSS), Card1.9 (D1), Card1.10 (D2), Card1.11 (GND), DSub1.5, DSub1.6, DSub1.7, DSub1.8, DSub1.10, DSub1.16, DSub1.17, H1.1, H2.1, H3.1, H4.1, J1.10, J2.8, LED1.2 (K), R3.2, R4.2, R9.2, R16.2, SW2.2, SW3.2, TP3.1, U1.1 (GND), U2.49 (EP), U3.3 (GND), U3.19 (GND), U3.33 (EP), U4.4 (GND), U5.1 (GND), U6.1 (GND), U6.5 (GND), U6.10 (AGND), U6.11 (GND), U6.13 (TEST), U6.15 (GND), U6.25 (GND), U6.35 (GND), U6.47 (GND), U6.51 (GND), USB1.13 (EH), USB1.14 (EH), USB1.A1B12 (GND), USB1.B1A12 (GND), USB2.13 (EH), USB2.14 (EH), USB2.A1B12 (GND), USB2.B1A12 (GND), X1.2 (GND), X1.4 (GND), X2.2 (GND), X2.4 (GND)
unnamed: Card1.8 (DAT1), R48.2
unnamed: Card1.1 (DAT2), R38.2
unnamed: F1.1, USB1.A4B9 (VBUS), USB1.B4A9 (VBUS)
unnamed: JP7.2 (B), U6.39 (BDBUS1)
unnamed: JP8.1 (A), U6.38 (BDBUS0)
unnamed: LED1.1 (A), R32.2
unnamed: LED2.1 (A), R36.2
unnamed: LED3.2 (K), R18.1
unnamed: R24.1, U2.21 (IOB_23b)
unnamed: R25.1, U2.13 (IOB_24a)
unnamed: R26.2, U2.20 (IOB_25b_G3)
unnamed: R28.2, U2.19 (IOB_29b)
unnamed: R29.1, U2.18 (IOB_31b)
unnamed: R27.2, U2.25 (IOT_36b)
unnamed: R31.1, U2.23 (IOT_37a)
unnamed: R30.1, U2.27 (IOT_38b)
unnamed: C5.2, C8.2, R33.2, U2.29 (VCCPLL)
unnamed: R6.2, U3.21 (D+)
unnamed: R5.2, U3.20 (D-)
unnamed: C4.2, U3.22 (VBCOMP)
unnamed: C7.1, U3.25 (X0), X1.1 (OSC1)
unnamed: C6.1, U3.24 (XI), X1.3 (OSC2)
unnamed: R35.2, U4.1 (~CS)
unnamed: R18.2, U6.54 (BCBUS3)
unnamed: R9.1, U6.41 (BDBUS3)
unnamed: R14.2, U6.7 (DM)
unnamed: R15.2, U6.8 (DP)
unnamed: C16.1, U6.2 (OSCI), X2.3 (OSC2)
unnamed: C15.1, U6.3 (OSCO), X2.1 (OSC1)
unnamed: R16.1, U6.6 (REF)
unnamed: C24.1, C40.2, L1.1, U6.4 (VPHY)
unnamed: C41.1, L2.1, U6.9 (VPLL)
unnamed: R17.2, U6.14 (~RESET)
unnamed: R40.1, USB1.A5 (CC1)
unnamed: R44.2, USB1.B5 (CC2)
unnamed: R3.1, USB2.A5 (CC1)
unnamed: R4.1, USB2.B5 (CC2)
VBUS: C1.1, F1.2, J1.12, LED4.2, R40.2, R44.1, TP4.1, U1.3 (VI), U5.3 (VI), USB2.A4B9 (VBUS), USB2.B4A9 (VBUS)

Notes on the sheet:
QSPI Flash
USB Controller
VGA
Custom FPGA Learning Board By darshg321!!
Connectors
FPGA
USB
JTAG
Programmer
SD Card
Miscellaneous

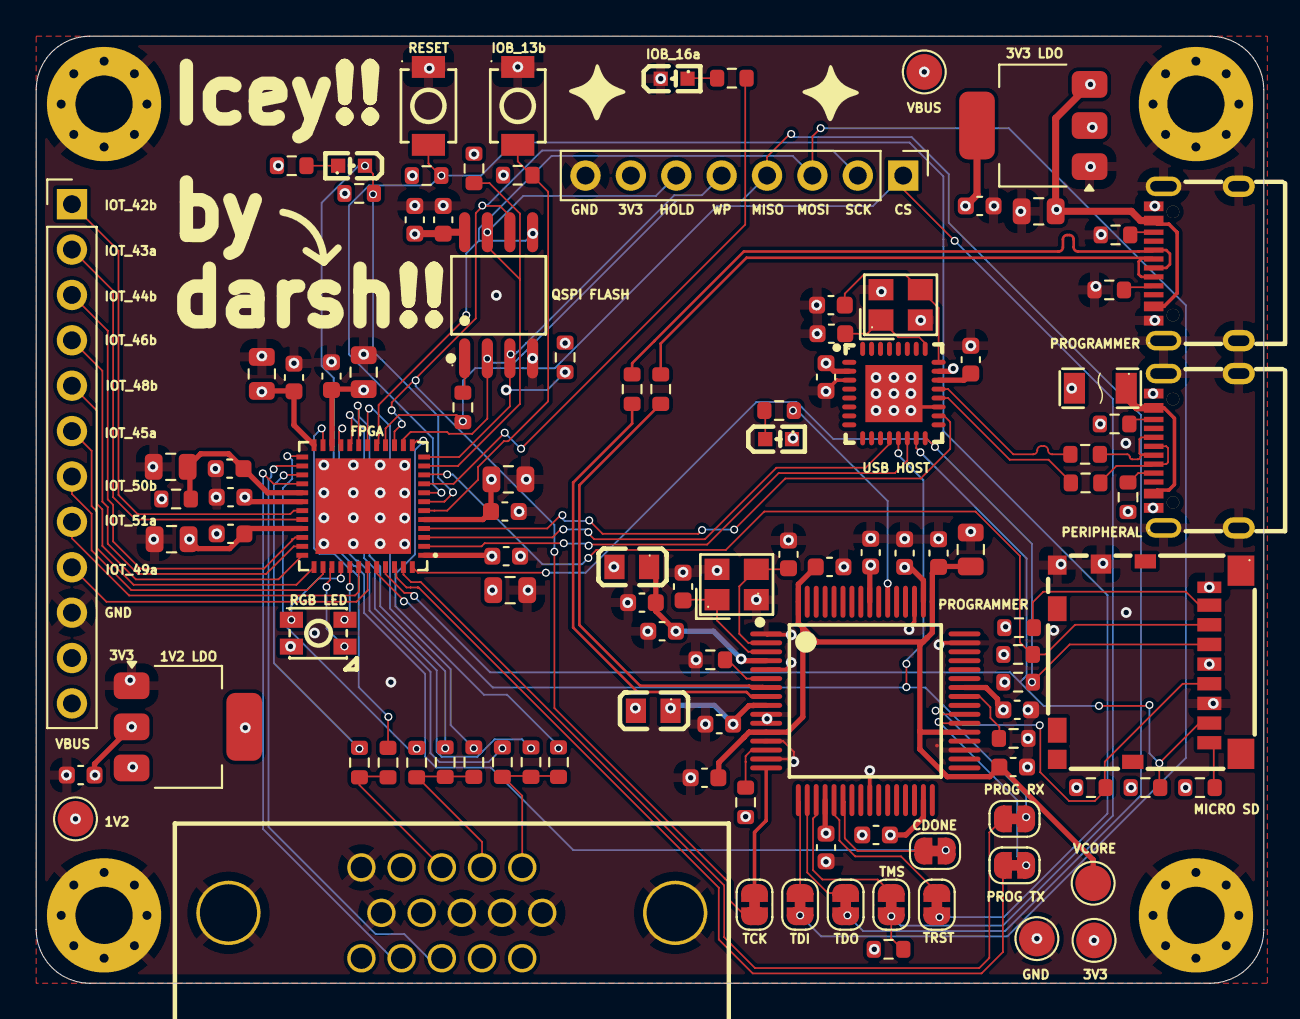
[picture p19: board Icey.kicad_pcb from above]

Board: 4 copper layers, 68.7 x 53.0 mm, 113 parts (0 on the bottom side), 88 nets.
