darshg321/Icey/(commit log)

2026-08-01 checkpoint: gnd plane done
2026-08-04 pcb ready, needs art
2026-08-17 added pcbway and oshwa
2026-10-12 Add firmware, tools and examples from board bring-up
    - firmware/README.md: bring-up notes and a feature checklist (designed vs
    tested on the real board). Rev-1 findings: stock iceprog can't drive the
    FTDI pinout, and flash boot is broken (SPI data lines crossed)
    - tools: iceyprog.py (programmer for Icey's FTDI pinout), setup.sh + udev
    rule, ice2v.py (Icestudio project -> Verilog without the GUI)
    - icey.pcf: full pin constraints
    - examples: blink, uart_flash, Icestudio blink / VGA demo / Game of Life
    - life-demo.sh: one-command Game of Life demo with a terminal show
    - firmware/icestudio: submodule, Icestudio fork with an Icey board
2026-10-12 Showcase demo uses the whole board; hardware tests; README video
    - examples/hwtest: UART->SPI bridge + hwtest.py (SD, USB host keyboard,
    SW2, RGB, LED3, SW3), read-only FAT32 reader
    - examples/icestudio/showcase.ice: Life engine + I/O bridge behind a
    command router; life-demo.sh now runs it with a board check, keyboard
    control via the board's USB host, SW2 and RGB status
    - checklist: SD (read), USB host, SW2, SW3, LED3, RGB mapping now tested
    - README: demo video and shorter firmware section
2026-10-12 Verify showcase keyboard controls; document showcase demo
    - keyboard poller tested with real keys (80 presses); pause, speed, new
    soup, glider gun, SW2 and next-act verified in the running show, quit
    checked with a scripted esc
    - firmware/README: showcase section (acts, controls, design), checklist rows
2026-10-12 Test SD writes and flash quad mode
    - hwtest.py sdwrite: write/read-back/restore of one unused sector
    - examples/flashtest: FPGA single vs quad SPI flash reads (bit-exact over
    the stored bitstream, 4x throughput)
    - checklist: microSD write and QSPI quad mode now tested
2026-10-12 Checklist: Icestudio Upload button tested in the GUI
2026-10-26 Learn: a Verilog course site for Icey, with the Make a chip project path
    A browser course (Yosys and nextpnr in WebAssembly, a gate-level simulator on a
    photo of the board) with 25 lessons, plus Make a chip: 14 project sessions from a
    first line of Verilog to a VGA chip ready for the GF180 shared-chip tapeout.
    Lessons use retrieval warm-ups, predictions, Parsons problems and linked
    readings in a side reader; see learn/PEDAGOGY.md.
